SAKSHAM-KAUSHIK/Buddy_Talking_Alarm_Clock/BUDDY_TALKING_ALARM/BUDDY___Talking_Alarm_Clock_Documentation.pdf

# BUDDY : The Talking Alarm Clock

# Electronics Design Workshop

## ECECC09

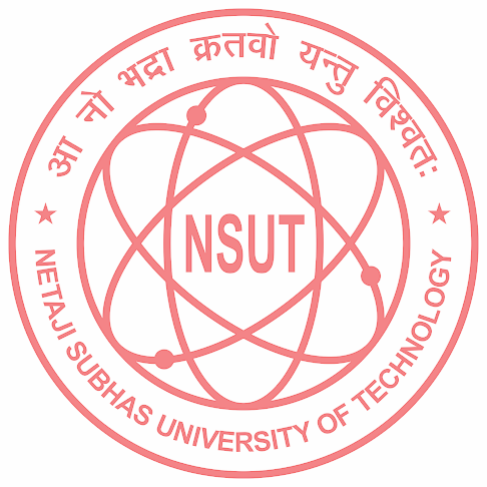
[picture p1: figure]

### RISHABH JAIN : 2020UEC2561

### SAKSHAM KAUSHIK : 2020UEC2563

### ANISH MITTAL : 2020UEC2570

### Under Supervision of : Prof. D.V. GADRE

## January, 2022 - April, 2022

Project : The Talking Alarm Clock | 2

### INDEX

1. Introduction
(a) Description of project
(b) Motivation
(c) Objectives
2. Components and Analysis
(a) RTC Module
(b) ESP32
(c) Audio Board
(d) Speaker
(e) LED Module
3. Working
4. Designing
(a) Hardware Designing
(b) Software Designing and Code
5. Setup and Fabrication
(a) Board Layout Design
(b) PCB Fabrication
(c) Connecting the Components
(d) Outer Case
6. Conclusion

# Project Documentation

### Rishabh Jain, Saksham Kaushik, Anish Mittal

### April 20, 2022

Abstract

We have learned many electronics concepts throughout the ECE Lab section

and applied almost all of them directly or indirectly in our EDW lab project.

Additionally, having taken away a lot from this course, we aimed to make a

project that would challenge us academically and intellectually. This

documentation contains a detailed explanation of our project ”BUDDY - The

Talking Alarm Clock”, an alarm clock that tells the time verbally so that

knowing time for the visually impaired is as easy as it is for us.

## 1 Introduction

### 1.1 Description

”BUDDY - The Talking Alarm Clock” as the name suggests, is an alarm clock that speaks out time loud for you whenever the ”Tell Time” Button is pressed. Along with speaking out time, one can set an alarm at the desired time using a combination of buttons. According to the 6-block model, every electronic circuit consists of 6 electronic device types demonstrated in the image below.

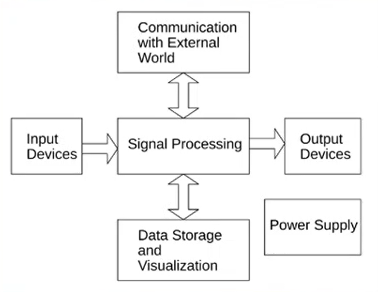
[picture p2: figure]

Figure 1: 6 Block Model

3

For the signal processing unit, ESP32 is used which is connected to the Real Time Clock Module (RTC) which is the input block. LED Module and speaker ,are used to display and speak the

time respectively, are the output block.

### 1.2 Motivation

The idea for this project was conceived during an illustrative class held by our respected Professor D.V. Gadre in which he demonstrated various projects developed by him and his students. The center of attraction for us was the projects developed to help the visually impaired students. Taking the inspiration from that, we decided to develop BUDDY The Talking Alarm Clock.

### 1.3 Objectives

We wanted to develop a project that makes the functions of a general alarm clock a seamless task for visually impaired people too. So, we included the following functionality in our clock:

1. Tell Time : BUDDY speaks out time for you.
2. Set Alarm: One can set an alarm at desired time of the day.

## 2 Components and Analysis

### 2.1 RTC Module

The DS3231 is a low-cost, extremely accurate I2C real-time clock (RTC) with an integrated Tem-perature Compensated Crystal Oscillator (TCXO) and crystal. The device incorporates a battery

input and maintains accurate timekeeping when the main power to the device is interrupted.

This module is used to provide the clock signal required for us to display the time. We will be using a DS3231 real-time clock signal which will be connected to the ESP32.

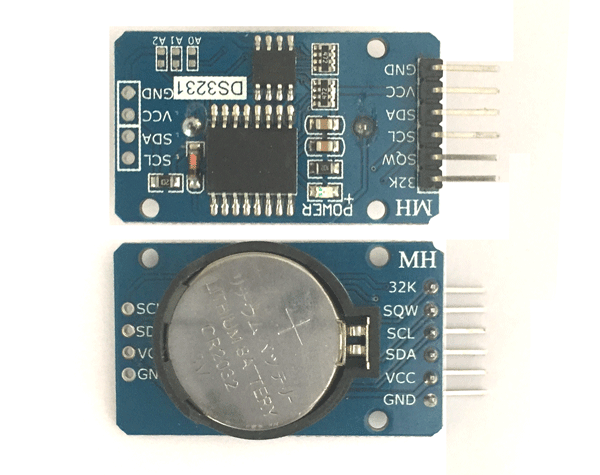
[picture p3: figure]

Figure 2: Image showing DS3231 real time clock

### 2.2 ESP32

ESP32 is a single 2.4 GHz Wi-Fi-and-Bluetooth combo chip . ESP32 has ample storage capacity with a flash memory of 4 MB. It is designed to achieve the best performance, showing robustness, versatility and reliability in a wide variety of applications and power scenarios.

The entire project centers around the ESP32 microcontroller. It is used here for less noise and better performance. We can easily connect and control electronic components for useful computing. We are using Arduino IDE to code the ESP32. Also, we are storing audio files in the flash memory.

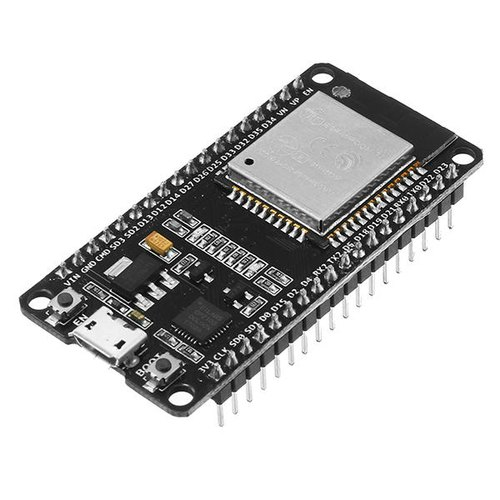
[picture p4: figure]

Figure 3: ESP32 microcontroller

### 2.3 Audio Board

We are using the PAM8403 IC, all parts of which are SMD components making it small in size and compatible. It is to amplify the audio signal given by the ESP32 DAC pin IO 25. So, the PAM8403 provides a very good sound and also minimizes part size.

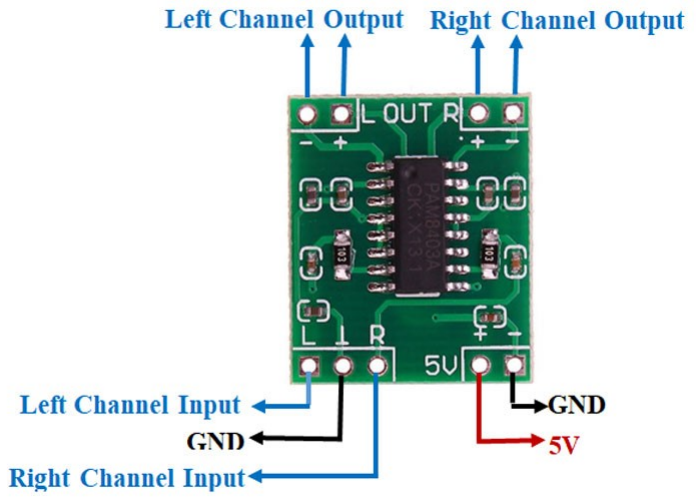
[picture p5: figure]

Figure 4: PAM8403 audio board

### 2.4 Speaker

We are using a 4ohm speaker which will play the music/audio file through audio board. The music/audio files are stored in the flash memory of ESP32.

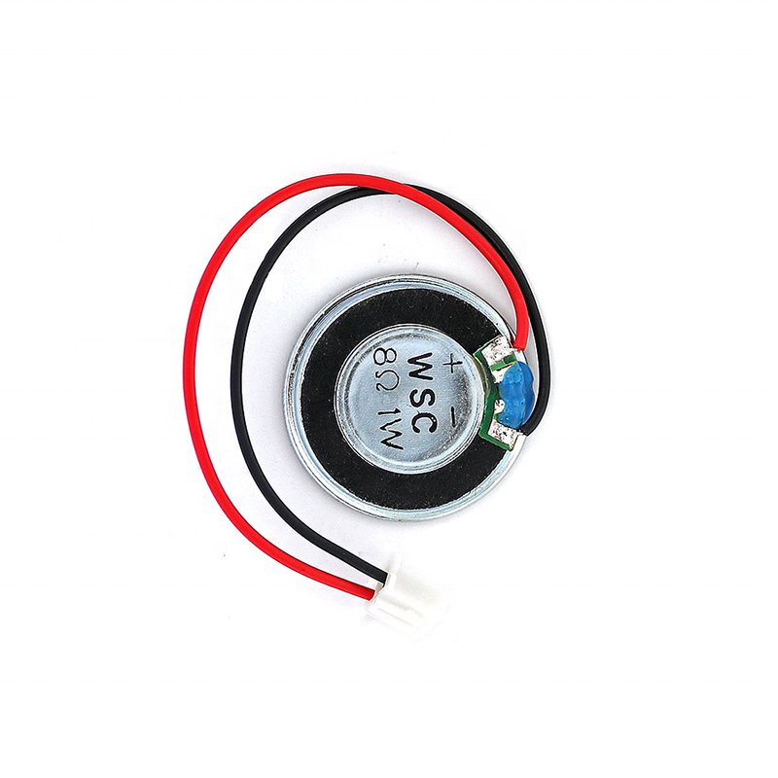
[picture p6: figure]

Figure 5: Speaker

### 2.5 LED Display Module

TM1637 DISPLAY module is used for displaying numbers. The module consists of four 7- segment displays working together.

Along with speaking the time, we are using a 4-digit led display to display the time and alarm information so that it can also work as a normal alarm clock.

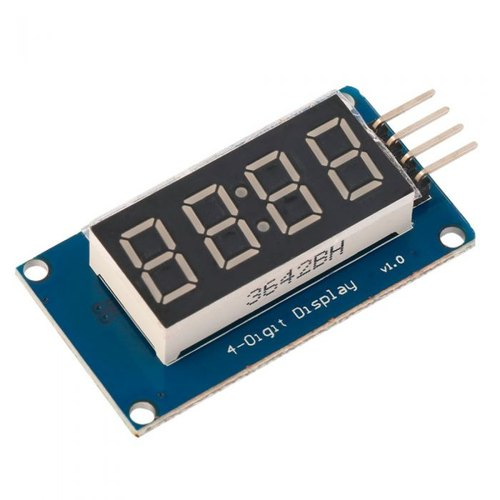
[picture p7: figure]

Figure 6: TM1637 LED Module

## 3 Working

### 3.1 Block diagram

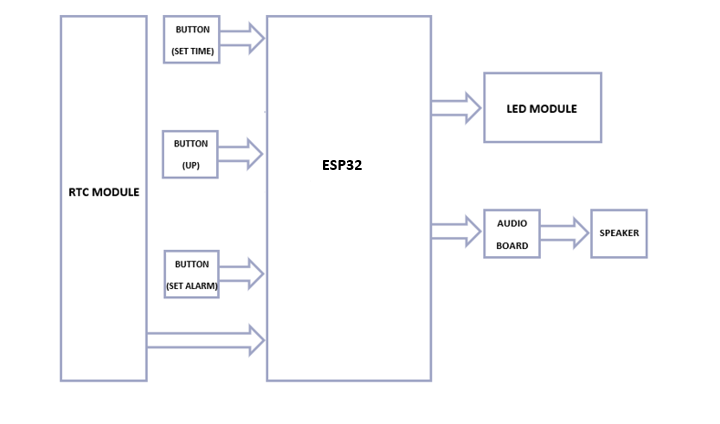
[picture p8: figure]

### 3.2 Flowcharts

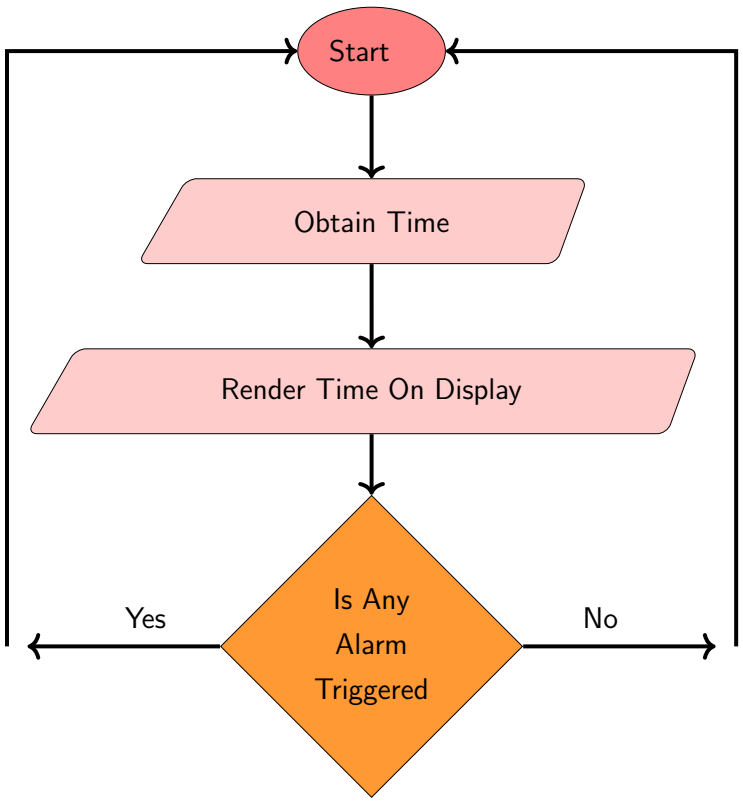
[picture p9: figure]
Start; Obtain Time; Render Time On Display; Is Any; Alarm; Triggered; Yes

Flowchart demonstration of Alarm Set

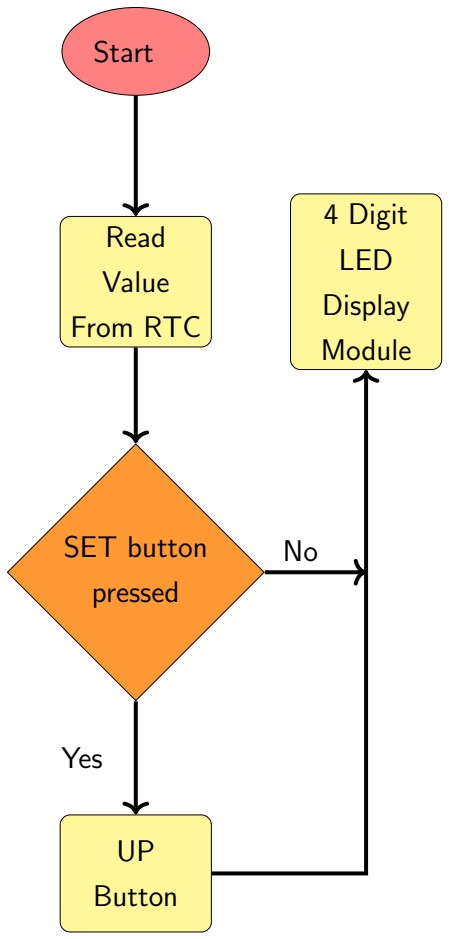
[picture p10: figure]
Start; Read; Value; From RTC; SET button; pressed; Button; 4 Digit; LED; Display; Module; Yes

Flowchart demonstration of Alarm Set

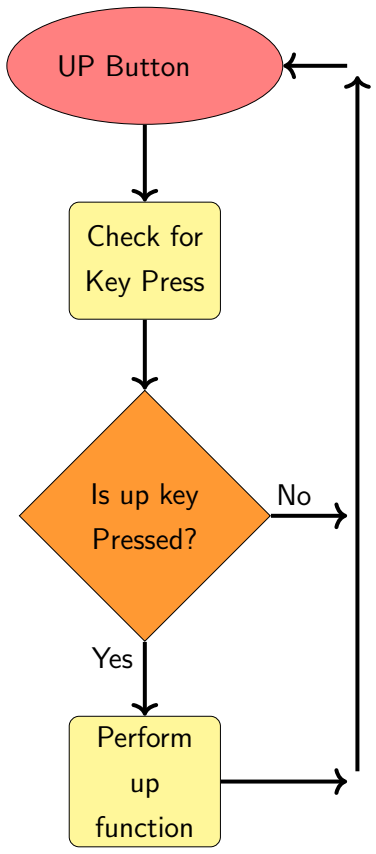
[picture p11: figure]
UP Button; Check for; Key Press; Is up key; Pressed?; Perform; function; Yes

Flowchart demonstration of UP operation

## 4 Designing

Moving to designing the circuit and PCB layout. We have used EAGLE software for designing the schematic and board layout file of the ciruit.

### 1. Hardware Design

A schematic was designed for PCB fabrication and a better explanation of connections. Following is a completely labelled circuit diagram for the project- BUDDY The Talking Alarm Clock.

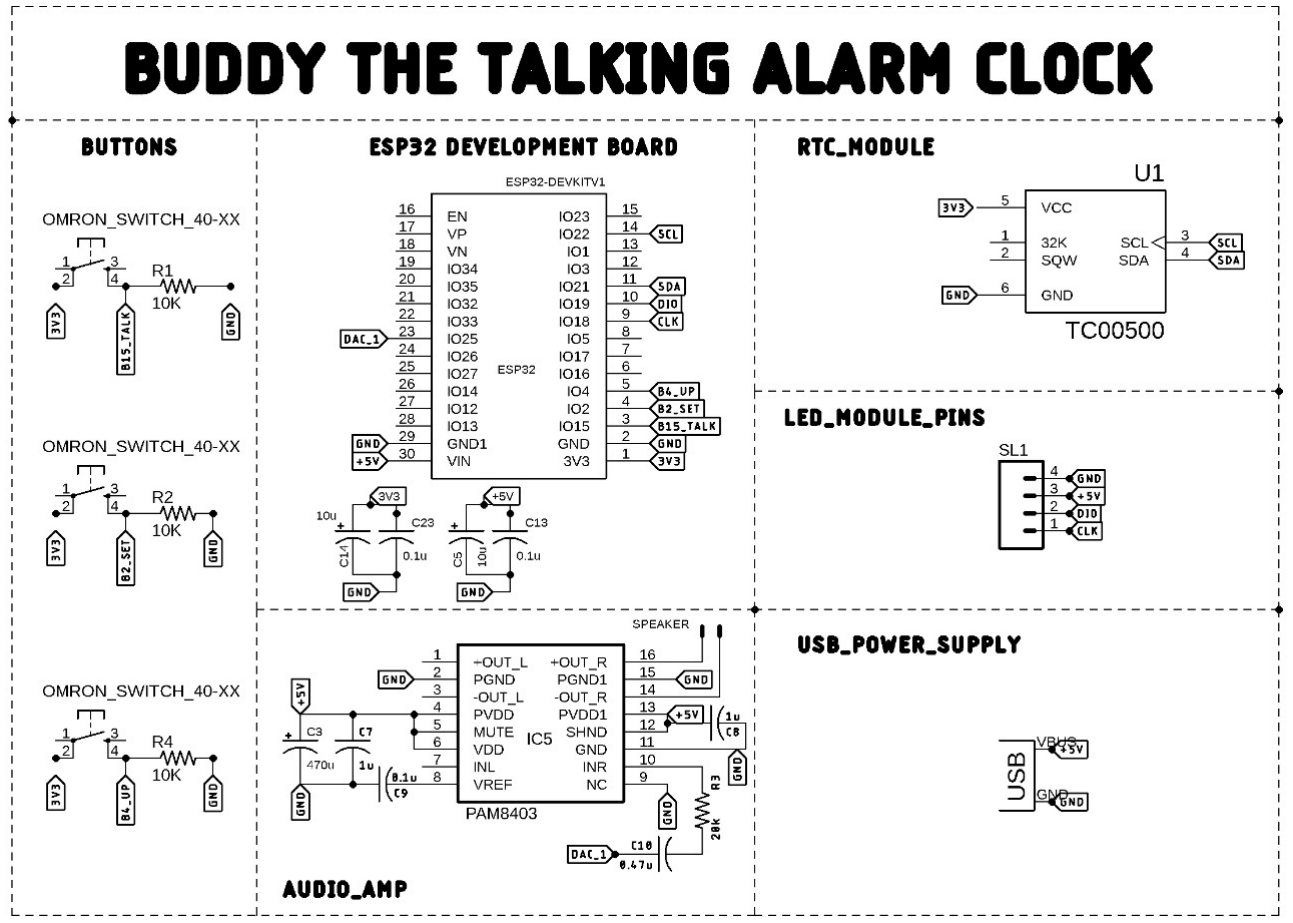
[picture p12: figure]

Figure 7: Schematic

As shown in the schematic above the PAM8403 is connected to DAC i.e. IO25 of ESP32.The Audio signal is being provided through this DAC IO25 only.The RTC module pins SDA is connected to IO21 and SCL is connected to IO22 of ESP32.The DIO and CLK of LED Module are connected to pin IO19 and IO18 of ESP32 respectively.The IO15 pin of ESP32 is connected to TELL TIME button and IO2 and IO4 pins of ESP32 are connected to SET and UP buttons respectively.All the Buttons and RTC are connected to 3V3 pin of ESP32 and ground and LED Module,Vin of ESP32 and PAM8403 are connected to +5V of USB mini and all GND pin are connected to ground of USB mini.

### 2. Software Design

Using Arduino Genuino IDE we have coded our ESP32 for different functionalities.

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

// l i b r a r i e s

#i n c l u d e ” SoundData . h”

#i n c l u d e ”XT DAC Audio . h”

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

#i n c l u d e <SPI . h>

#i n c l u d e <Wi re . h> RTC DS1307 r t c ;

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

NOTE C5 , NOTE C5 , NOTE G5 , NOTE G5 , NOTE A5 , NOTE A5 , NOTE G5 , BEAT 2 , NOTE F5 , NOTE F5 , NOTE E5 , NOTE E5 , NOTE D5 , NOTE D5 , NOTE C5 , BEAT 2 , NOTE G5 , NOTE G5 , NOTE F5 , NOTE F5 , NOTE E5 , NOTE E5 , NOTE D5 , BEAT 2 , NOTE G5 , NOTE G5 , NOTE F5 , NOTE F5 , NOTE E5 , NOTE E5 , NOTE D5 , BEAT 2 , NOTE C5 , NOTE C5 , NOTE G5 , NOTE G5 , NOTE A5 , NOTE A5 , NOTE G5 , BEAT 2 , NOTE F5 , NOTE F5 , NOTE E5 , NOTE E5 , NOTE D5 , NOTE D5 , NOTE C5 , BEAT 4 , NOTE SILENCE , BEAT 5 , SCORE END
} ;
XT M u s i c S co r e C l a s s Music ( Twi nkl eTwi nkl e ,TEMPO ALLEGRO, INSTRUMENT PIANO ) ; // C r e a t e t h e main p l a y e r c l a s s o b j e c t .
// Use GPIO 25 , one of t h e 2 DAC p i n s and t i m e r 0
XT DAC Audio Cla s s DacAudio (25 , 0 ) ;
XT Wav Class Am(AM) ;
XT Wav Class Pm(PM) ;
XT Wav Class TheTimeIs (THETIMEIS ) ;
XT Wav Class T heAla rmI sSe tTo (THEALARMISETO ) ; XT Wav Class Ze ro (ZERO ) ;
XT Wav Class OClock (OCLOCK ) ;
XT Wav Class One (ONE ) ;
XT Wav Class Two(TWO) ;
XT Wav Class Th ree (THREE ) ; XT Wav Class Fou r (FOUR ) ; XT Wav Class F i v e ( FIVE ) ;

XT Wav Class S i x ( SIX ) ;
XT Wav Class Seven (SEVEN ) ; XT Wav Class E i g h t ( EIGHT ) ; XT Wav Class Nine (NINE ) ;
XT Wav Class Ten (TEN ) ;
XT Wav Class E l e v e n (ELEVEN ) ;
XT Wav Class Twelve (TWELVE ) ;
XT Wav Class T h i r t e e n (THIRTEEN ) ; XT Wav Class Fo u r t e e n (FOURTEEN ) ; XT Wav Class F i f t e e n ( FIFTEEN ) ;
XT Wav Class S i x t e e n ( SIXTEEN ) ;
XT Wav Class S e v e n t e e n (SEVENTEEN ) ; XT Wav Class E i g h t e e n (EIGHTEEN ) ; XT Wav Class N i n e t e e n (NINTEEN ) ;
XT Wav Class Twenty (TWENTY) ;
XT Wav Class T h i r t y (THIRTY ) ; XT Wav Class F o r t y (FOURTY ) ; XT Wav Class F i f t y ( FIFTY ) ;

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

i n t ala rm h =6;
i n t alarmm =00;
i n t alarm am pm = 0 ;
long x=m i l l i s ( ) ;
const i n t c l c = 1 8; //ForTM1637 LED d i s p l a y (CLK) const i n t da ta = 1 9; //ForTM1637 LED d i s p l a y ( DIO ) u i n t 8 t d i g i t s [ ] = { 0 x3f , 0 x06 , 0 x5b , 0 x4f ,
0 x66 , 0 x6d , 0 x7d , 0 x07 , 0 x7f , 0 x 6f } ;
i n t n=0; // f o r s e t t i n g ho u r s , m i n u t e s and am/pm

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

s t a r t ( ) ;

w r i t e V a l u e (0 x8c ) ;
s t o p ( ) ;
w r i t e (0 x00 , 0 x00 , 0 x00 , 0 x00 ) ;

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

}
}

void l o o p ( ) {

| DateTime now = r t c . now ( ) ; // u se d to g e t tim e f rom RTC( DS3231 )
| i n t v =0; //AM PM
| i n t h=now . ho u r ( ) ;
| i n t m=now . mi n u te ( ) ;
| i n t s=now . s e co n d ( ) ;
| i f ( h>11){
| v =1;
}
| i f ( h>12) { h=h−12;

}

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

}

// u se d to p l a y ala rm on t h e s e t ala rm tim e
i f ( h==ala rm h && m==alarmm && v==alarm am pm ) {
i f ( Music . P l a y i n g==f a l s e ) | { | // i f no t p l a y i n g
DacAudio . P la y (&Music ) ;
}
}
DacAudio . F i l l B u f f e r ( ) ;

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

while ( m i l l i s ()−x <500){

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

w r i t e (0 x00 , d i g i t s [ h % 1 0]
| ( ( 0 x00 ) << 7 ) , d i g i t s [m/ 1 0] , d i g i t s [m % 1 0 ] ) ; }
e l s e {
w r i t e ( d i g i t s [ h / 1 0] , d i g i t s [ h % 1 0]
| ( ( 0 x00 ) << 7 ) , d i g i t s [m / 1 0] , d i g i t s [m % 1 0 ] ) ; }
}

while ( m i l l i s ()−x <500){

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

// f u n c t i o n s

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

PinUp i s t h e p i n f o r t h e Up Bu t ton .
i f ( n==0){

++ala rm h ;
i f ( ala rmh >12){

ala rm h =1;
}
}

e l s e i f ( n==1){

++alarmm ;
i f ( alarmm>=60){

alarmm =0;
}
}

e l s e i f ( n==2){
alarm am pm=(alarm am pm+1)%2; }

i s A l a r m P r e s s e d ( pinUp , ala rmh , alarmm , alarm am pm ) ; }

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

Se q ue nce . A d dPlayI tem (&TheTimeIs ) ; i f ( h==1){
Se q ue nce . A d dPlayI tem (&One ) ; }
e l s e i f ( h==2){
Se q ue nce . A d dPlayI tem (&Two ) ; }
e l s e i f ( h==3){
Se q ue nce . A d dPlayI tem (&Th ree ) ; }
e l s e i f ( h==4){
Se q ue nce . A d dPlayI tem (& Fou r ) ; }
e l s e i f ( h==5){
Se q ue nce . A d dPlayI tem (& F i v e ) ; }
e l s e i f ( h==6){
Se q ue nce . A d dPlayI tem (& S i x ) ; }
e l s e i f ( h==7){
Se q ue nce . A d dPlayI tem (& Seven ) ; }
e l s e i f ( h==8){
Se q ue nce . A d dPlayI tem (& E i g h t ) ; }
e l s e i f ( h==9){
Se q ue nce . A d dPlayI tem (&Nine ) ; }
e l s e i f ( h==10){
Se q ue nce . A d dPlayI tem (&Ten ) ; }
e l s e i f ( h==11){
Se q ue nce . A d dPlayI tem (& E l e v e n ) ; }
e l s e i f ( h==12){
Se q ue nce . A d dPlayI tem (&Twelve ) ; }

i f (m==0){
Se q ue nce . A d dPlayI tem (&OClock ) ; }

e l s e i f (m==1){
Se q ue nce . A d dPlayI tem (&Ze ro ) ; Se q ue nce . A d dPlayI tem (&One ) ; }
e l s e i f (m==2){
Se q ue nce . A d dPlayI tem (&Ze ro ) ; Se q ue nce . A d dPlayI tem (&Two ) ; }
e l s e i f (m==3){
Se q ue nce . A d dPlayI tem (&Ze ro ) ; Se q ue nce . A d dPlayI tem (&Th ree ) ; }
e l s e i f (m==4){
Se q ue nce . A d dPlayI tem (&Ze ro ) ; Se q ue nce . A d dPlayI tem (& Fou r ) ; }
e l s e i f (m==5){
Se q ue nce . A d dPlayI tem (&Ze ro ) ; Se q ue nce . A d dPlayI tem (& F i v e ) ; }
e l s e i f (m==6){
Se q ue nce . A d dPlayI tem (&Ze ro ) ; Se q ue nce . A d dPlayI tem (& S i x ) ; }
e l s e i f (m==7){
Se q ue nce . A d dPlayI tem (&Ze ro ) ; Se q ue nce . A d dPlayI tem (& Seven ) ; }
e l s e i f (m==8){
Se q ue nce . A d dPlayI tem (&Ze ro ) ; Se q ue nce . A d dPlayI tem (& E i g h t ) ; }
e l s e i f (m==9){
Se q ue nce . A d dPlayI tem (&Ze ro ) ; Se q ue nce . A d dPlayI tem (&Nine ) ; }
e l s e i f (m==10){
Se q ue nce . A d dPlayI tem (&Ten ) ; }
e l s e i f (m==11){
Se q ue nce . A d dPlayI tem (& E l e v e n ) ; }
e l s e i f (m==12){
Se q ue nce . A d dPlayI tem (&Twelve ) ; }
e l s e i f (m==13){
Se q ue nce . A d dPlayI tem (& T h i r t e e n ) ; }

e l s e i f (m==14){
Se q ue nce . A d dPlayI tem (& Fo u r t e e n ) ; }
e l s e i f (m==15){
Se q ue nce . A d dPlayI tem (& F i f t e e n ) ; }
e l s e i f (m==16){
Se q ue nce . A d dPlayI tem (& S i x t e e n ) ; }
e l s e i f (m==17){
Se q ue nce . A d dPlayI tem (& S e v e n t e e n ) ; }
e l s e i f (m==18){
Se q ue nce . A d dPlayI tem (& E i g h t e e n ) ; }
e l s e i f (m==19){
Se q ue nce . A d dPlayI tem (& N i n e t e e n ) ; }
e l s e i f (m==20){
Se q ue nce . A d dPlayI tem (&Twenty ) ; }
e l s e i f (m==21){
Se q ue nce . A d dPlayI tem (&Twenty ) ; Se q ue nce . A d dPlayI tem (&One ) ;
}
e l s e i f (m==22){
Se q ue nce . A d dPlayI tem (&Twenty ) ; Se q ue nce . A d dPlayI tem (&Two ) ; }
e l s e i f (m==23){
Se q ue nce . A d dPlayI tem (&Twenty ) ; Se q ue nce . A d dPlayI tem (&Th ree ) ; }
e l s e i f (m==24){
Se q ue nce . A d dPlayI tem (&Twenty ) ; Se q ue nce . A d dPlayI tem (& Fou r ) ; }
e l s e i f (m==25){
Se q ue nce . A d dPlayI tem (&Twenty ) ; Se q ue nce . A d dPlayI tem (& F i v e ) ; }
e l s e i f (m==26){
Se q ue nce . A d dPlayI tem (&Twenty ) ; Se q ue nce . A d dPlayI tem (& S i x ) ;
}
e l s e i f (m==27){
Se q ue nce . A d dPlayI tem (&Twenty ) ; Se q ue nce . A d dPlayI tem (& Seven ) ;

}
e l s e i f (m==28){
Se q ue nce . A d dPlayI tem (&Twenty ) ; Se q ue nce . A d dPlayI tem (& E i g h t ) ; }
e l s e i f (m==29){
Se q ue nce . A d dPlayI tem (&Twenty ) ; Se q ue nce . A d dPlayI tem (&Nine ) ; }
e l s e i f (m==30){
Se q ue nce . A d dPlayI tem (& T h i r t y ) ; }
e l s e i f (m==31){
Se q ue nce . A d dPlayI tem (& T h i r t y ) ; Se q ue nce . A d dPlayI tem (&One ) ;
}
e l s e i f (m==32){
Se q ue nce . A d dPlayI tem (& T h i r t y ) ; Se q ue nce . A d dPlayI tem (&Two ) ;
}
e l s e i f (m==33){
Se q ue nce . A d dPlayI tem (& T h i r t y ) ; Se q ue nce . A d dPlayI tem (&Th ree ) ; }
e l s e i f (m==34){
Se q ue nce . A d dPlayI tem (& T h i r t y ) ; Se q ue nce . A d dPlayI tem (& Fou r ) ; }
e l s e i f (m==35){
Se q ue nce . A d dPlayI tem (& T h i r t y ) ; Se q ue nce . A d dPlayI tem (& F i v e ) ;
}
e l s e i f (m==36){
Se q ue nce . A d dPlayI tem (& T h i r t y ) ; Se q ue nce . A d dPlayI tem (& S i x ) ;
}
e l s e i f (m==37){
Se q ue nce . A d dPlayI tem (& T h i r t y ) ; Se q ue nce . A d dPlayI tem (& Seven ) ; }
e l s e i f (m==38){
Se q ue nce . A d dPlayI tem (& T h i r t y ) ; Se q ue nce . A d dPlayI tem (& E i g h t ) ; }
e l s e i f (m==39){
Se q ue nce . A d dPlayI tem (& T h i r t y ) ; Se q ue nce . A d dPlayI tem (&Nine ) ; }

e l s e i f (m==40){
Se q ue nce . A d dPlayI tem (& F o r t y ) ; }
e l s e i f (m==41){
Se q ue nce . A d dPlayI tem (& F o r t y ) ; Se q ue nce . A d dPlayI tem (&One ) ; }
e l s e i f (m==42){
Se q ue nce . A d dPlayI tem (& F o r t y ) ; Se q ue nce . A d dPlayI tem (&Two ) ; }
e l s e i f (m==43){
Se q ue nce . A d dPlayI tem (& F o r t y ) ; Se q ue nce . A d dPlayI tem (&Th ree ) ; }
e l s e i f (m==44){
Se q ue nce . A d dPlayI tem (& F o r t y ) ; Se q ue nce . A d dPlayI tem (& Fou r ) ; }
e l s e i f (m==45){
Se q ue nce . A d dPlayI tem (& F o r t y ) ; Se q ue nce . A d dPlayI tem (& F i v e ) ; }
e l s e i f (m==46){
Se q ue nce . A d dPlayI tem (& F o r t y ) ; Se q ue nce . A d dPlayI tem (& S i x ) ;
}
e l s e i f (m==47){
Se q ue nce . A d dPlayI tem (& F o r t y ) ; Se q ue nce . A d dPlayI tem (& Seven ) ; }
e l s e i f (m==48){
Se q ue nce . A d dPlayI tem (& F o r t y ) ; Se q ue nce . A d dPlayI tem (& E i g h t ) ; }
e l s e i f (m==49){
Se q ue nce . A d dPlayI tem (& F o r t y ) ; Se q ue nce . A d dPlayI tem (&Nine ) ; }
e l s e i f (m==50){
Se q ue nce . A d dPlayI tem (& F i f t y ) ; }
e l s e i f (m==51){
Se q ue nce . A d dPlayI tem (& F i f t y ) ; Se q ue nce . A d dPlayI tem (&One ) ; }
e l s e i f (m==52){
Se q ue nce . A d dPlayI tem (& F i f t y ) ;

Se q ue nce . A d dPlayI tem (&Two ) ; }
e l s e i f (m==53){
Se q ue nce . A d dPlayI tem (& F i f t y ) ; Se q ue nce . A d dPlayI tem (&Th ree ) ; }
e l s e i f (m==54){
Se q ue nce . A d dPlayI tem (& F i f t y ) ; Se q ue nce . A d dPlayI tem (& Fou r ) ; }
e l s e i f (m==55){
Se q ue nce . A d dPlayI tem (& F i f t y ) ; Se q ue nce . A d dPlayI tem (& F i v e ) ;
}
e l s e i f (m==56){
Se q ue nce . A d dPlayI tem (& F i f t y ) ; Se q ue nce . A d dPlayI tem (& S i x ) ;
}
e l s e i f (m==57){
Se q ue nce . A d dPlayI tem (& F i f t y ) ; Se q ue nce . A d dPlayI tem (& Seven ) ; }
e l s e i f (m==58){
Se q ue nce . A d dPlayI tem (& F i f t y ) ; Se q ue nce . A d dPlayI tem (& E i g h t ) ;
}
e l s e i f (m==59){
Se q ue nce . A d dPlayI tem (& F i f t y ) ; Se q ue nce . A d dPlayI tem (&Nine ) ; }
i f ( v==0){
Se q ue nce . A d dPlayI tem (&Am) ; }
e l s e i f ( v==1){
Se q ue nce . A d dPlayI tem (&Pm ) ; }
}

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

Se q ue nce . A d dPlayI tem (&T heAla rmI sSe tTo ) ;
i f ( h==1){
Se q ue nce . A d dPlayI tem (&One ) ;
}
e l s e i f ( h==2){
Se q ue nce . A d dPlayI tem (&Two ) ; }

e l s e i f ( h==3){
Se q ue nce . A d dPlayI tem (&Th ree ) ; }
e l s e i f ( h==4){
Se q ue nce . A d dPlayI tem (& Fou r ) ; }
e l s e i f ( h==5){
Se q ue nce . A d dPlayI tem (& F i v e ) ; }
e l s e i f ( h==6){
Se q ue nce . A d dPlayI tem (& S i x ) ; }
e l s e i f ( h==7){
Se q ue nce . A d dPlayI tem (& Seven ) ; }
e l s e i f ( h==8){
Se q ue nce . A d dPlayI tem (& E i g h t ) ; }
e l s e i f ( h==9){
Se q ue nce . A d dPlayI tem (&Nine ) ; }
e l s e i f ( h==10){
Se q ue nce . A d dPlayI tem (&Ten ) ; }
e l s e i f ( h==11){
Se q ue nce . A d dPlayI tem (& E l e v e n ) ; }
e l s e i f ( h==12){
Se q ue nce . A d dPlayI tem (&Twelve ) ; }

i f (m==0){
Se q ue nce . A d dPlayI tem (&OClock ) ; }
e l s e i f (m==1){
Se q ue nce . A d dPlayI tem (&Ze ro ) ; Se q ue nce . A d dPlayI tem (&One ) ; }
e l s e i f (m==2){
Se q ue nce . A d dPlayI tem (&Ze ro ) ; Se q ue nce . A d dPlayI tem (&Two ) ; }
e l s e i f (m==3){
Se q ue nce . A d dPlayI tem (&Ze ro ) ; Se q ue nce . A d dPlayI tem (&Th ree ) ; }
e l s e i f (m==4){
Se q ue nce . A d dPlayI tem (&Ze ro ) ;

Se q ue nce . A d dPlayI tem (& Fou r ) ; }
e l s e i f (m==5){
Se q ue nce . A d dPlayI tem (&Ze ro ) ; Se q ue nce . A d dPlayI tem (& F i v e ) ; }
e l s e i f (m==6){
Se q ue nce . A d dPlayI tem (&Ze ro ) ; Se q ue nce . A d dPlayI tem (& S i x ) ; }
e l s e i f (m==7){
Se q ue nce . A d dPlayI tem (&Ze ro ) ; Se q ue nce . A d dPlayI tem (& Seven ) ; }
e l s e i f (m==8){
Se q ue nce . A d dPlayI tem (&Ze ro ) ; Se q ue nce . A d dPlayI tem (& E i g h t ) ; }
e l s e i f (m==9){
Se q ue nce . A d dPlayI tem (&Ze ro ) ; Se q ue nce . A d dPlayI tem (&Nine ) ; }
e l s e i f (m==10){
Se q ue nce . A d dPlayI tem (&Ten ) ; }
e l s e i f (m==11){
Se q ue nce . A d dPlayI tem (& E l e v e n ) ; }
e l s e i f (m==12){
Se q ue nce . A d dPlayI tem (&Twelve ) ; }
e l s e i f (m==13){
Se q ue nce . A d dPlayI tem (& T h i r t e e n ) ; }
e l s e i f (m==14){
Se q ue nce . A d dPlayI tem (& Fo u r t e e n ) ; }
e l s e i f (m==15){
Se q ue nce . A d dPlayI tem (& F i f t e e n ) ; }
e l s e i f (m==16){
Se q ue nce . A d dPlayI tem (& S i x t e e n ) ; }
e l s e i f (m==17){
Se q ue nce . A d dPlayI tem (& S e v e n t e e n ) ; }
e l s e i f (m==18){
Se q ue nce . A d dPlayI tem (& E i g h t e e n ) ;

}
e l s e i f (m==19){
Se q ue nce . A d dPlayI tem (& N i n e t e e n ) ; }
e l s e i f (m==20){
Se q ue nce . A d dPlayI tem (&Twenty ) ; }
e l s e i f (m==21){
Se q ue nce . A d dPlayI tem (&Twenty ) ; Se q ue nce . A d dPlayI tem (&One ) ;
}
e l s e i f (m==22){
Se q ue nce . A d dPlayI tem (&Twenty ) ; Se q ue nce . A d dPlayI tem (&Two ) ; }
e l s e i f (m==23){
Se q ue nce . A d dPlayI tem (&Twenty ) ; Se q ue nce . A d dPlayI tem (&Th ree ) ; }
e l s e i f (m==24){
Se q ue nce . A d dPlayI tem (&Twenty ) ; Se q ue nce . A d dPlayI tem (& Fou r ) ; }
e l s e i f (m==25){
Se q ue nce . A d dPlayI tem (&Twenty ) ; Se q ue nce . A d dPlayI tem (& F i v e ) ; }
e l s e i f (m==26){
Se q ue nce . A d dPlayI tem (&Twenty ) ; Se q ue nce . A d dPlayI tem (& S i x ) ;
}
e l s e i f (m==27){
Se q ue nce . A d dPlayI tem (&Twenty ) ; Se q ue nce . A d dPlayI tem (& Seven ) ; }
e l s e i f (m==28){
Se q ue nce . A d dPlayI tem (&Twenty ) ; Se q ue nce . A d dPlayI tem (& E i g h t ) ; }
e l s e i f (m==29){
Se q ue nce . A d dPlayI tem (&Twenty ) ; Se q ue nce . A d dPlayI tem (&Nine ) ; }
e l s e i f (m==30){
Se q ue nce . A d dPlayI tem (& T h i r t y ) ; }
e l s e i f (m==31){
Se q ue nce . A d dPlayI tem (& T h i r t y ) ;

Se q ue nce . A d dPlayI tem (&One ) ; }
e l s e i f (m==32){
Se q ue nce . A d dPlayI tem (& T h i r t y ) ; Se q ue nce . A d dPlayI tem (&Two ) ;
}
e l s e i f (m==33){
Se q ue nce . A d dPlayI tem (& T h i r t y ) ; Se q ue nce . A d dPlayI tem (&Th ree ) ; }
e l s e i f (m==34){
Se q ue nce . A d dPlayI tem (& T h i r t y ) ; Se q ue nce . A d dPlayI tem (& Fou r ) ; }
e l s e i f (m==35){
Se q ue nce . A d dPlayI tem (& T h i r t y ) ; Se q ue nce . A d dPlayI tem (& F i v e ) ;
}
e l s e i f (m==36){
Se q ue nce . A d dPlayI tem (& T h i r t y ) ; Se q ue nce . A d dPlayI tem (& S i x ) ;
}
e l s e i f (m==37){
Se q ue nce . A d dPlayI tem (& T h i r t y ) ; Se q ue nce . A d dPlayI tem (& Seven ) ; }
e l s e i f (m==38){
Se q ue nce . A d dPlayI tem (& T h i r t y ) ; Se q ue nce . A d dPlayI tem (& E i g h t ) ; }
e l s e i f (m==39){
Se q ue nce . A d dPlayI tem (& T h i r t y ) ; Se q ue nce . A d dPlayI tem (&Nine ) ; }
e l s e i f (m==40){
Se q ue nce . A d dPlayI tem (& F o r t y ) ; }
e l s e i f (m==41){
Se q ue nce . A d dPlayI tem (& F o r t y ) ; Se q ue nce . A d dPlayI tem (&One ) ; }
e l s e i f (m==42){
Se q ue nce . A d dPlayI tem (& F o r t y ) ; Se q ue nce . A d dPlayI tem (&Two ) ; }
e l s e i f (m==43){
Se q ue nce . A d dPlayI tem (& F o r t y ) ; Se q ue nce . A d dPlayI tem (&Th ree ) ;

}
e l s e i f (m==44){
Se q ue nce . A d dPlayI tem (& F o r t y ) ; Se q ue nce . A d dPlayI tem (& Fou r ) ; }
e l s e i f (m==45){
Se q ue nce . A d dPlayI tem (& F o r t y ) ; Se q ue nce . A d dPlayI tem (& F i v e ) ; }
e l s e i f (m==46){
Se q ue nce . A d dPlayI tem (& F o r t y ) ; Se q ue nce . A d dPlayI tem (& S i x ) ;
}
e l s e i f (m==47){
Se q ue nce . A d dPlayI tem (& F o r t y ) ; Se q ue nce . A d dPlayI tem (& Seven ) ; }
e l s e i f (m==48){
Se q ue nce . A d dPlayI tem (& F o r t y ) ; Se q ue nce . A d dPlayI tem (& E i g h t ) ; }
e l s e i f (m==49){
Se q ue nce . A d dPlayI tem (& F o r t y ) ; Se q ue nce . A d dPlayI tem (&Nine ) ; }
e l s e i f (m==50){
Se q ue nce . A d dPlayI tem (& F i f t y ) ; }
e l s e i f (m==51){
Se q ue nce . A d dPlayI tem (& F i f t y ) ; Se q ue nce . A d dPlayI tem (&One ) ; }
e l s e i f (m==52){
Se q ue nce . A d dPlayI tem (& F i f t y ) ; Se q ue nce . A d dPlayI tem (&Two ) ; }
e l s e i f (m==53){
Se q ue nce . A d dPlayI tem (& F i f t y ) ; Se q ue nce . A d dPlayI tem (&Th ree ) ; }
e l s e i f (m==54){
Se q ue nce . A d dPlayI tem (& F i f t y ) ; Se q ue nce . A d dPlayI tem (& Fou r ) ; }
e l s e i f (m==55){
Se q ue nce . A d dPlayI tem (& F i f t y ) ; Se q ue nce . A d dPlayI tem (& F i v e ) ;
}

e l s e i f (m==56){
Se q ue nce . A d dPlayI tem (& F i f t y ) ; Se q ue nce . A d dPlayI tem (& S i x ) ;
}
e l s e i f (m==57){
Se q ue nce . A d dPlayI tem (& F i f t y ) ; Se q ue nce . A d dPlayI tem (& Seven ) ; }
e l s e i f (m==58){
Se q ue nce . A d dPlayI tem (& F i f t y ) ; Se q ue nce . A d dPlayI tem (& E i g h t ) ;
}
e l s e i f (m==59){
Se q ue nce . A d dPlayI tem (& F i f t y ) ; Se q ue nce . A d dPlayI tem (&Nine ) ; }
i f ( v==0){
Se q ue nce . A d dPlayI tem (&Am) ; }
e l s e i f ( v==1){
Se q ue nce . A d dPlayI tem (&Pm ) ; }
}

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

w r i t e V a l u e ( f i r s t ) ;

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

r e tu rn ack ;
}

## 5 Setup and Fabrication

### 5.1 Board Layout Design

Autodesk EAGLE software has been used to design PCB for the project. Board layout for the same is as follows:

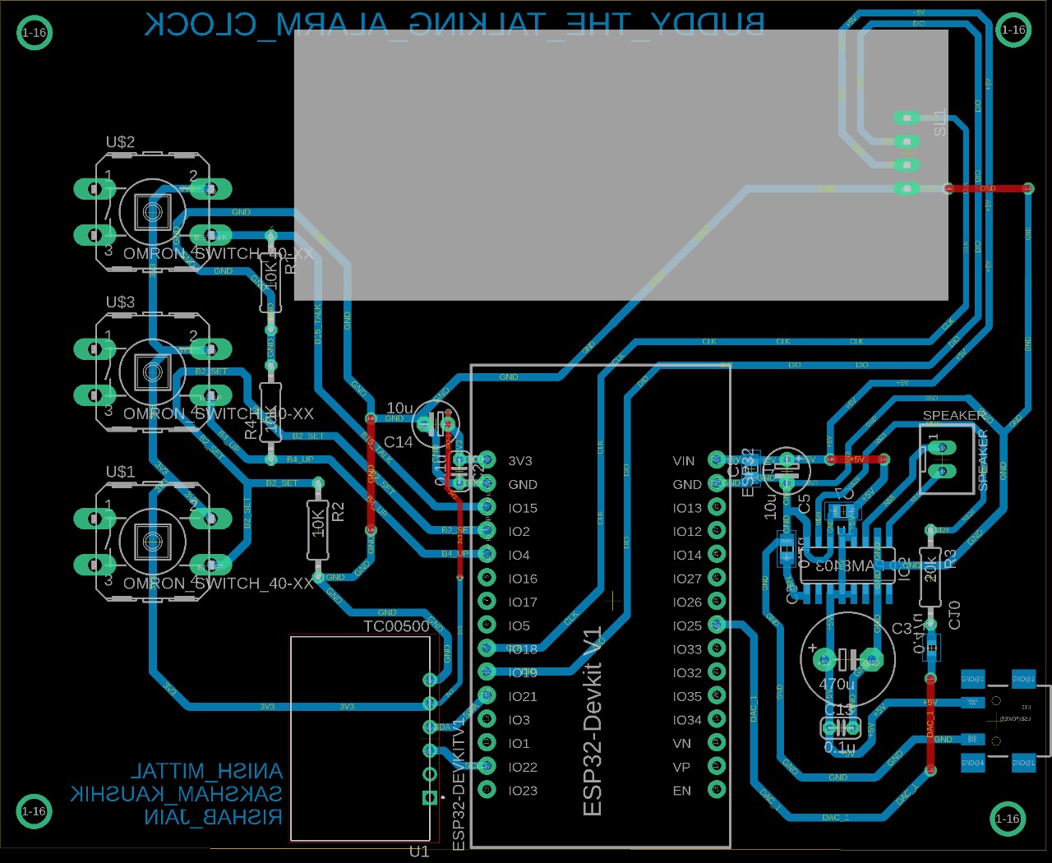
[picture p13: figure]

Figure 8: Board Layout for PCB Design

### 5.2 PCB Fabrication :

Follow the below steps for PCB fabrication:

### 1. Copper Clad Cutting Copper Clad of desired size, as made in software design , was cut

using a CNC(Computer Numeric Control) machine.

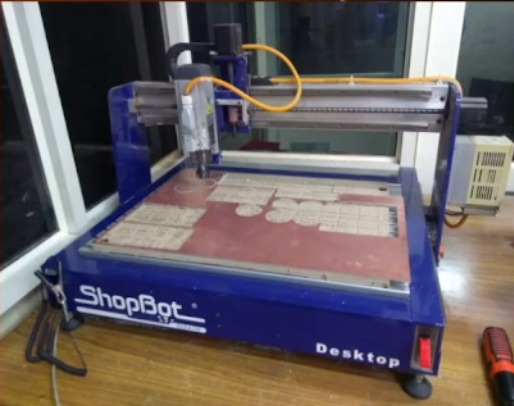
[picture p14: figure]

Figure 9: Copper Clad cutting

2. Sanding : The copper clad cut so far may have attracted fingerprints and scratches which

can cause problems in PCB fabrication. Hence, sanding is done on copper clad .

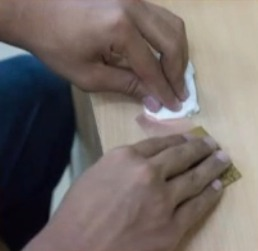
[picture p15: figure]

Figure 10: Sanding

### 3. Printing and Pressing Board layout on Copper : The Board layout made above is printed

and using iron press , it is aligned and pasted on the PCB. Then , after waiting for it to cool down , we use water to remove excess paper off the copper.

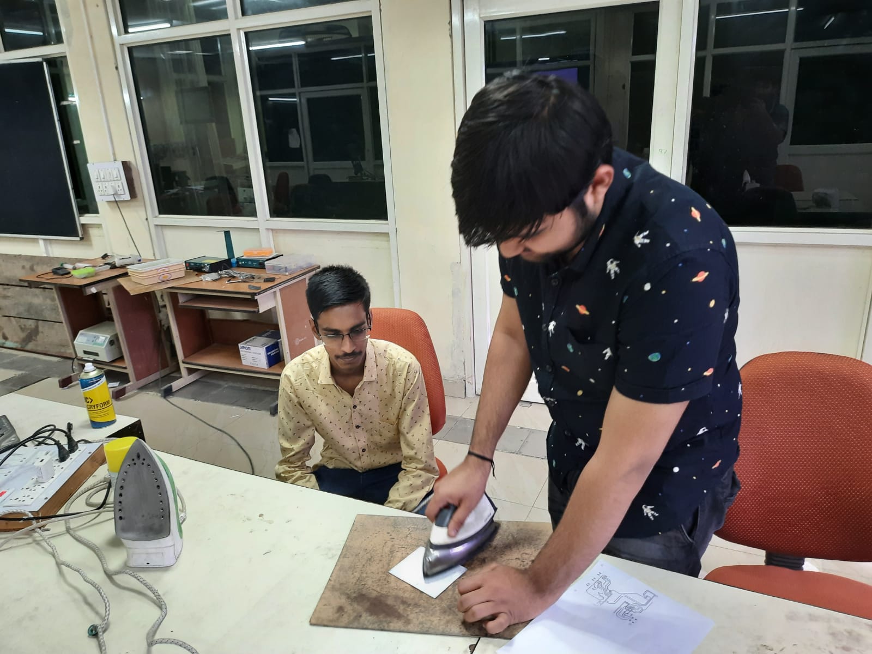
[picture p16: figure]

Figure 11: Pressing

4. Etching : FeCl3 solution is used for etching, This solution dissolves all the copper on the clad but the connections as the connections are covered with a layer of ink.

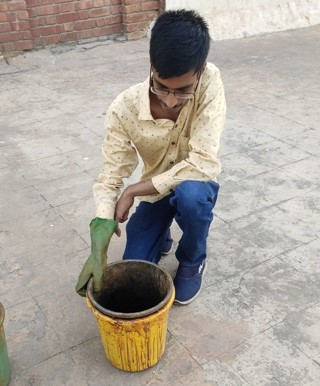
[picture p17: figure]

Figure 12: Etching

5. Scrubbing : Then the layer on connections is removed by scrubbing.

### 6. Conformal Coating Spray : This is coated with conformal coating spray which provides

protection from moisture, shock etc to the PCB.

7. Holes Drilling : Now holes are drilled for the stands and at the specified postions where through-hole components are needed to be placed .

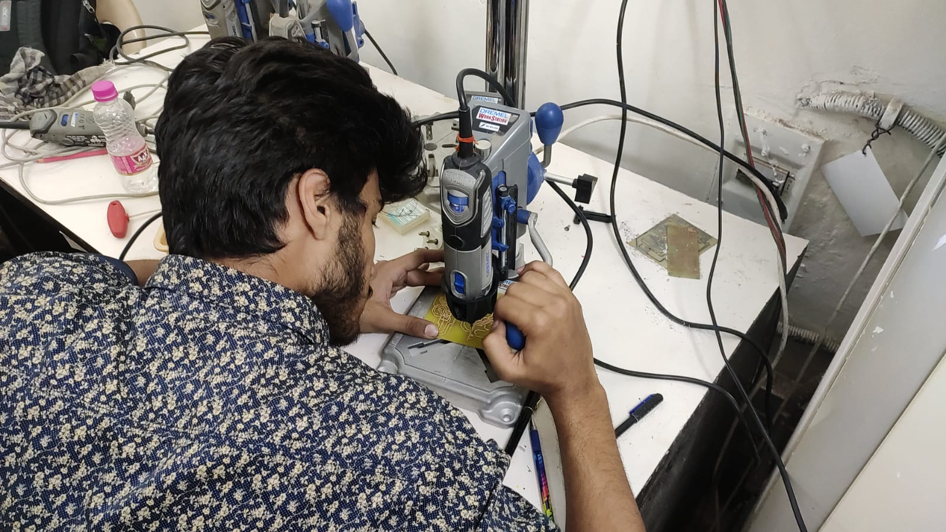
[picture p18: figure]

Figure 13: Drilling holes

### 5.3 Connecting the Components

All the components are soldered at their specific positions after programming ESP32 with the above code.

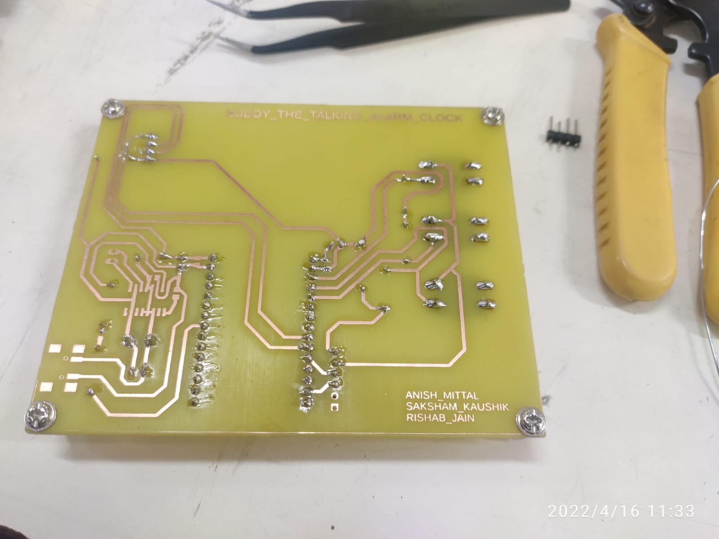
[picture p19: figure]

Figure 14: Soldering

### 5.4 Outer Case

We have used acrylic to make the outer case for this clock.First we designed cutouts for speaker, Display and buttons by using PartWorks software and then used CNC machine to cut it into desired size .

Then this is screwed on both sides which acts as a case for our setup.

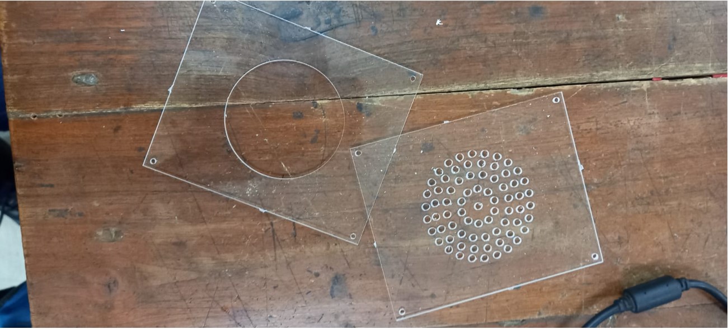
[picture p20: figure]

Figure 15: Acrylic Cutting

## 6 Conclusion

The fully Functioning Model of our Project BUDDY The Talking Alarm Clock was obtained with all the functions working properly including Tell Time and Set Alarm. A glimpse of final prototype is shown below.

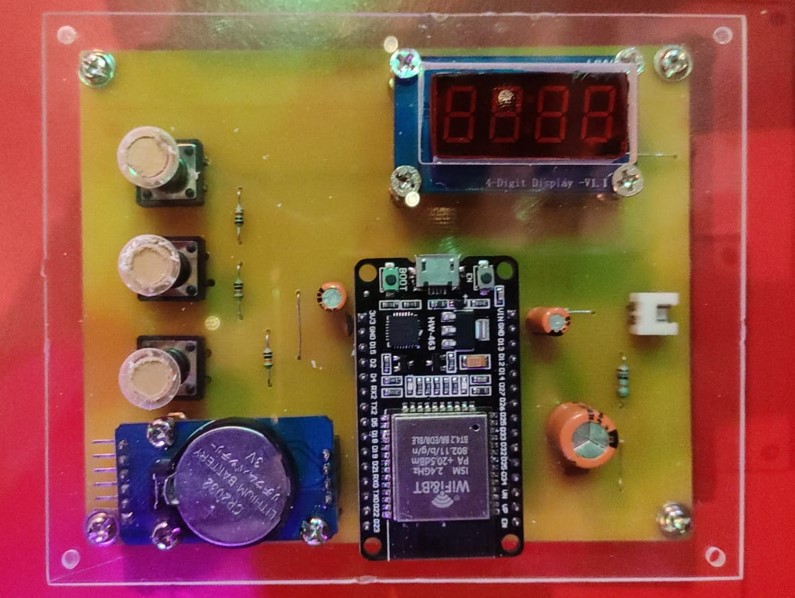
[picture p21: figure]
