SAKSHAM-KAUSHIK/Buddy_Talking_Alarm_Clock/BUDDY_TALKING_ALARM/BUDDY_BEST (1).brd

## EAGLE design BUDDY_TALKING_ALARM/BUDDY_BEST (1).brd (2022-07-02)

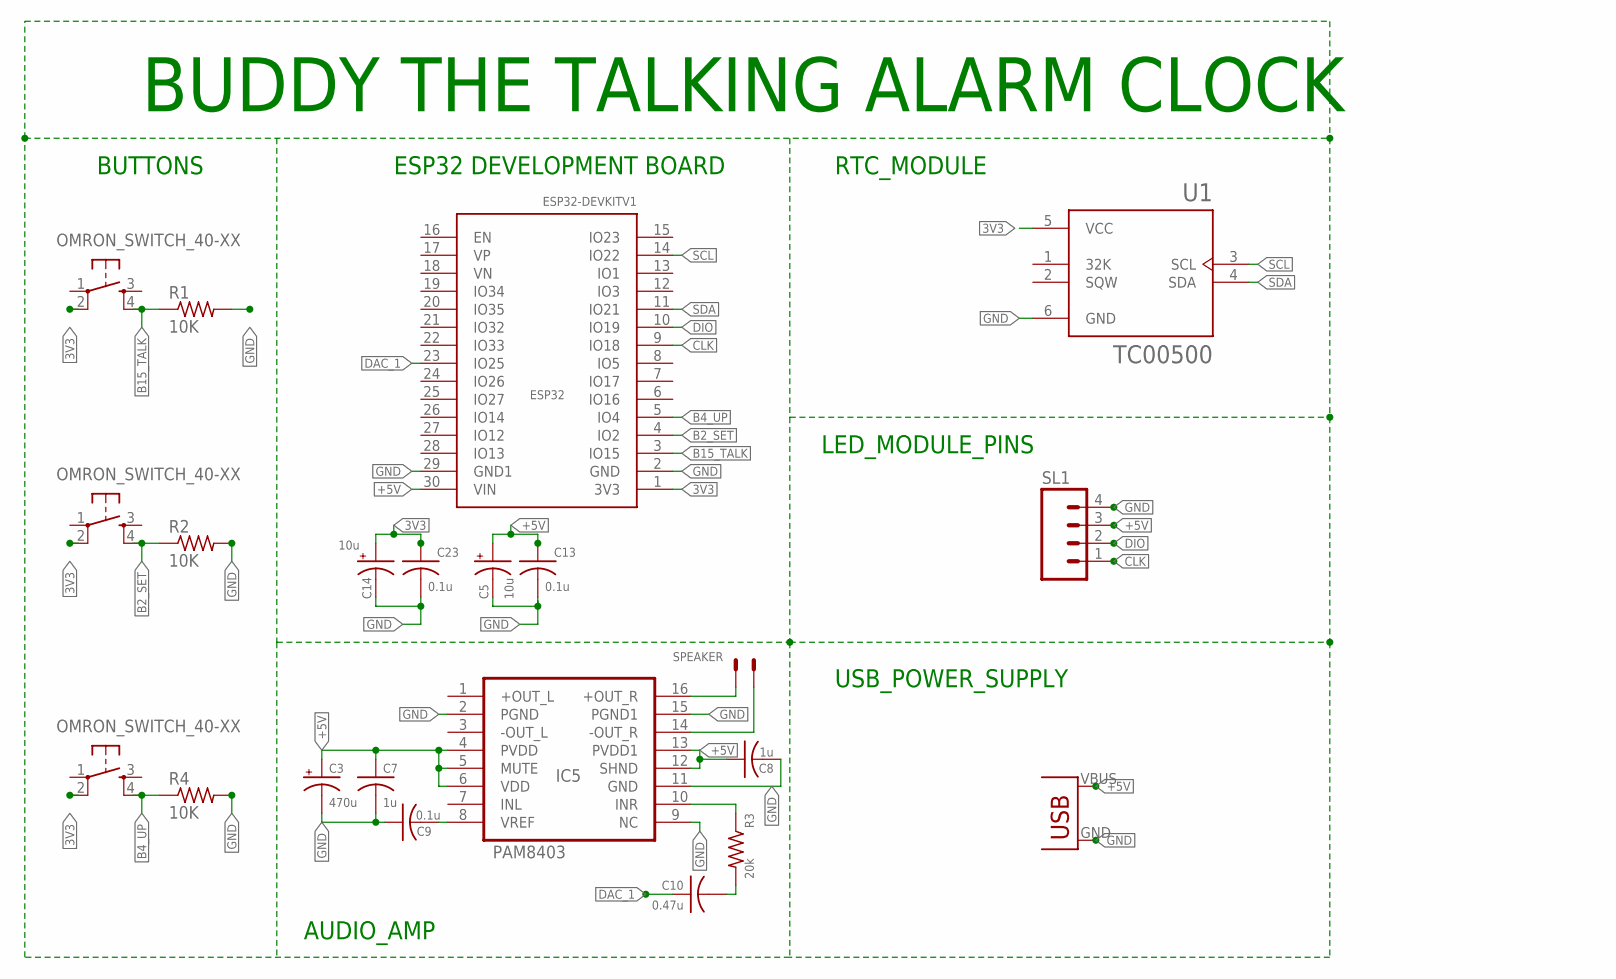
[picture p22: schematic BUDDY_BEST (1).sch]

Parts:
C3: 470u; E5-10,5
C5, C14: 10u; E2,5-5
C7, C8: 1u; C0805
C9: 0.1u; C0805
C10: 0.47u; C0603
C13, C23: 0.1u; C025-024X044
ESP32: ESP32-DEVKITV1_ESP32DEVKITV1ESP32; ESP32
IC5: PAM8403; SOP-16
R1, R2, R4: 10K; 0207/10
R3: 20k; 0207/10
SL1: M04; 04P
SPEAKER: SPEAKER; JST-XH-02-PACKAGE-LONG-PAD
U1: TC00500; MODULE_TC00500
U$1, U$2, U$3: OMRON_SWITCH_40-XX; B3F-40XX
U$5: USB(POWER)

Connections:
3V3: C14.+, C23.1, ESP32.1 (3V3), U1.5 (VCC), U$1.2 (P1), U$2.2 (P1), U$3.2 (P1)
+5V: C3.+, C5.+, C7.1, C8.1, C13.1, ESP32.30 (VIN), IC5.4 (PVDD), IC5.5 (MUTE), IC5.6 (VDD), IC5.12 (SHND), IC5.13 (PVDD1), SL1.3, U$5.VBUS (VCC)
B2_SET: ESP32.4 (IO2), R2.1, U$1.4 (S1)
B4_UP: ESP32.5 (IO4), R4.1, U$3.4 (S1)
B15_TALK: ESP32.3 (IO15), R1.1, U$2.4 (S1)
CLK: ESP32.9 (IO18), SL1.1
DAC_1: C10.1, ESP32.23 (IO25)
DIO: ESP32.10 (IO19), SL1.2
GND: C3.-, C5.-, C7.2, C8.2, C9.1, C13.2, C14.-, C23.2, ESP32.2 (GND), ESP32.29 (GND1), IC5.2 (PGND), IC5.9 (NC), IC5.11 (GND), IC5.15 (PGND1), R1.2, R2.2, R4.2, SL1.4, U1.6 (GND), U$5.GND
unnamed: IC5.16 (+OUT_R), SPEAKER.2
unnamed: IC5.14 (-OUT_R), SPEAKER.1
unnamed: C9.2, IC5.8 (VREF)
unnamed: C10.2, R3.2
unnamed: IC5.10 (INR), R3.1
SCL: ESP32.14 (IO22), U1.3 (SCL)
SDA: ESP32.11 (IO21), U1.4 (SDA)

Notes on the sheet:
BUDDY THE TALKING ALARM CLOCK
ESP32 DEVELOPMENT BOARD
AUDIO_AMP
RTC_MODULE
LED_MODULE_PINS
USB_POWER_SUPPLY
BUTTONS

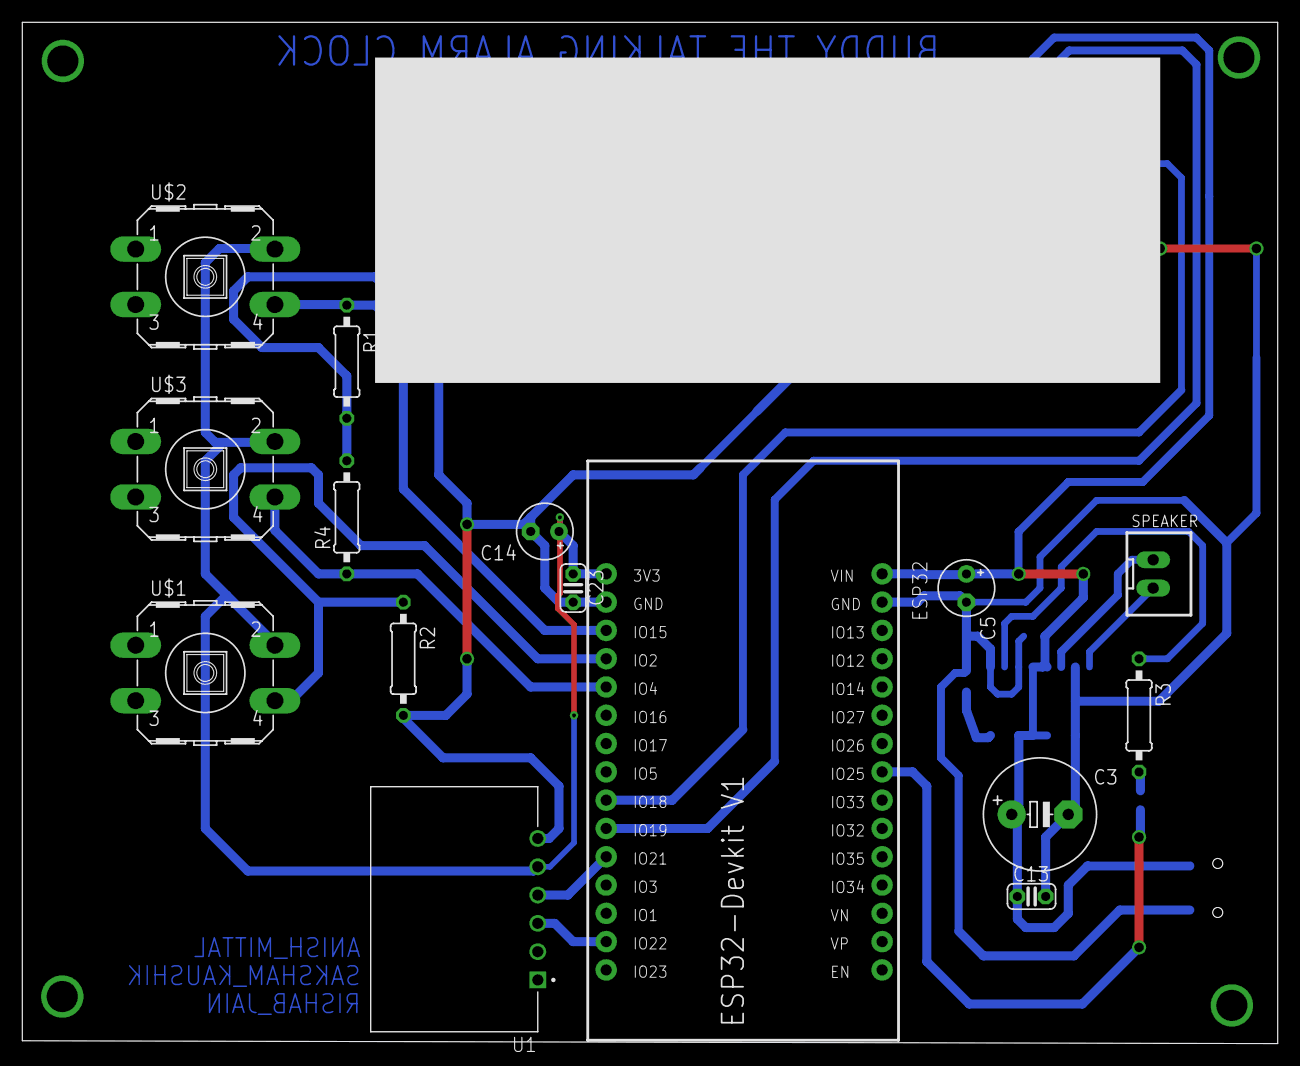
[picture p23: board BUDDY_BEST (1).brd from above]

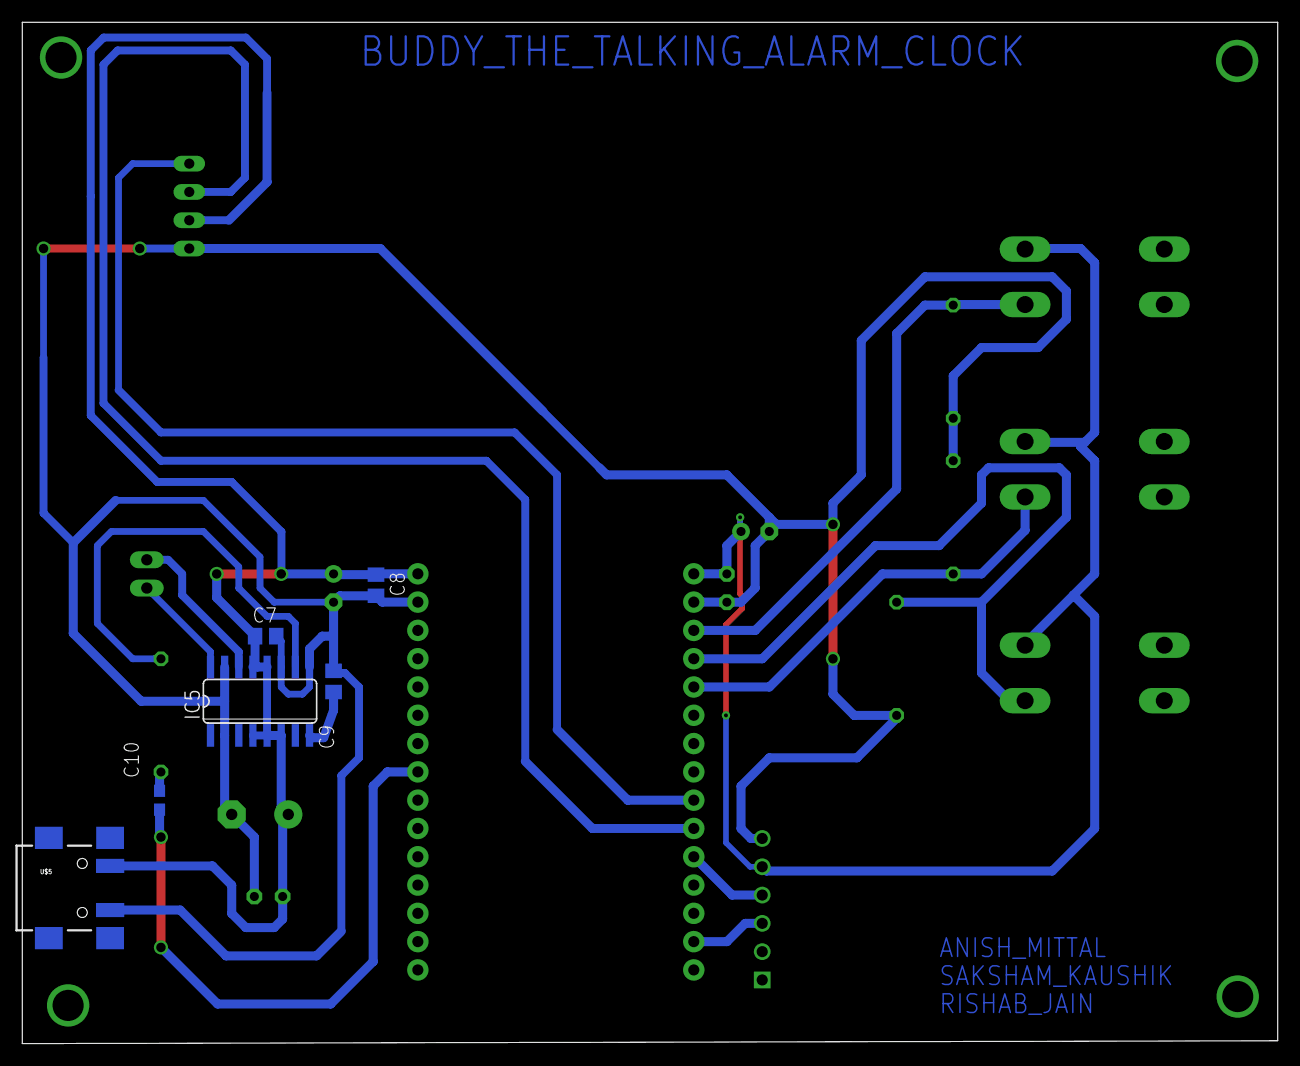
[picture p24: board BUDDY_BEST (1).brd from below]

Board: 2 copper layers, 112.7 x 91.7 mm, 22 parts (6 on the bottom side), 16 nets.
